phamngocty/quickshifter-esp32c3/docs/images/wiring-overview.jpg

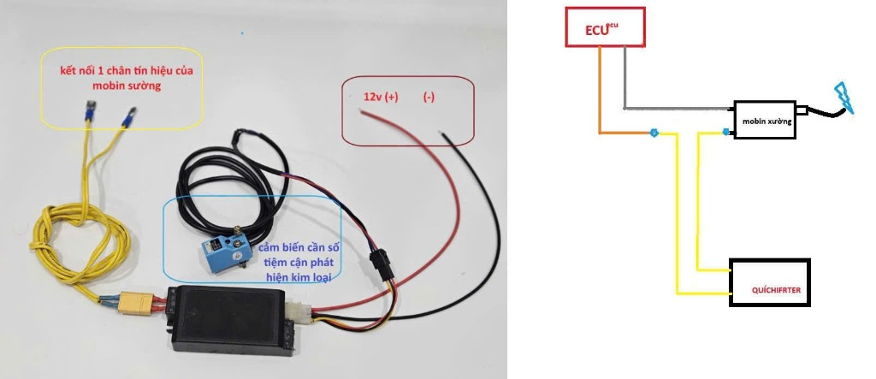
docs/images/wiring-overview.jpg
