phamngocty/quickshifter-esp32c3/docs/images/sensor-install.jpg

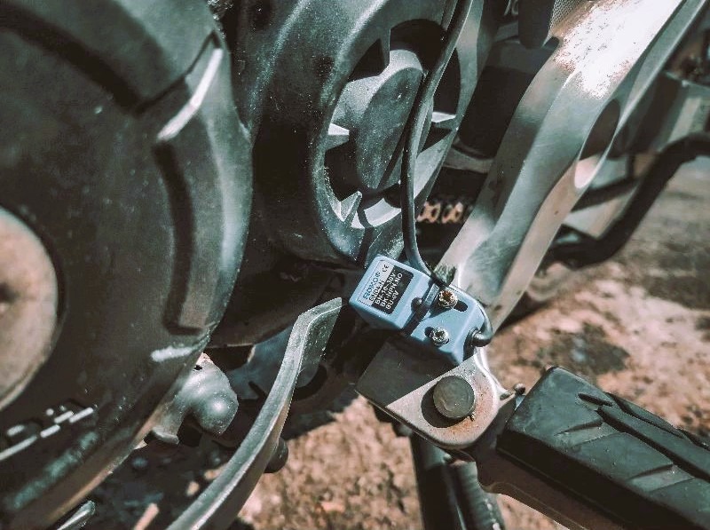
docs/images/sensor-install.jpg
