phamngocty/quickshifter-esp32c3/.gitnexus/context.md

### [00:22:28 26/3/2026]
**User:** luôn trả lời tiếng việt
