phamngocty/quickshifter-esp32c3/docs/nhiemvu.md

tôi muốn thêm chế độ Backfire manual  và tab backfrire
kịch bản thực tế hoạt động như sau :
xe đang mở khóa đang chạy bình thường Khi nhấn giữ Shift npn lớn hơn 3 giây (thời gian này có thể điều chỉnh )
