phamngocty/quickshifter-esp32c3/docs/images/control-box.jpg

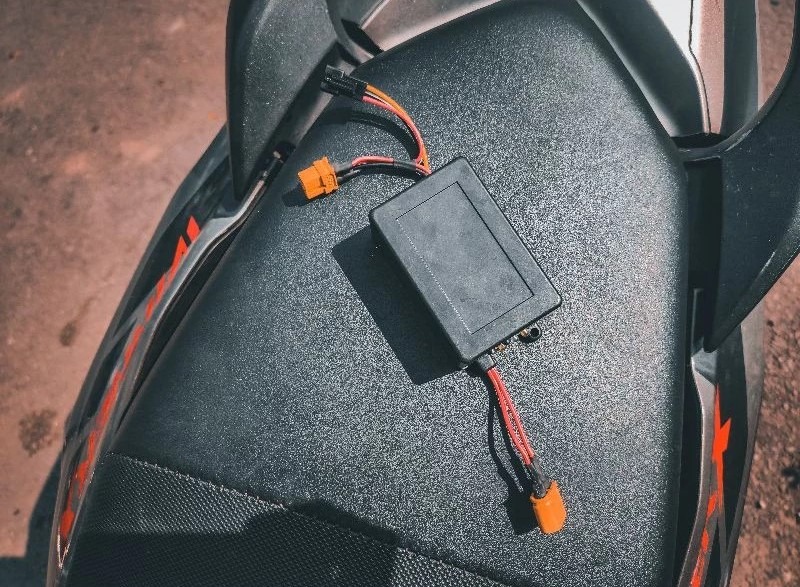
docs/images/control-box.jpg
