phamngocty/quickshifter-esp32c3/docs/images/mobin-real.png

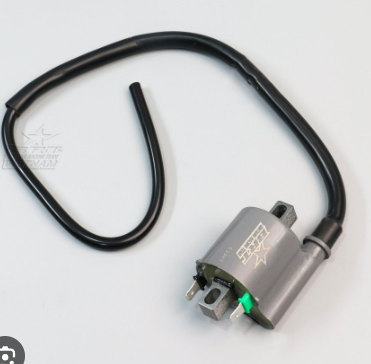
docs/images/mobin-real.png
