phamngocty/quickshifter-esp32c3/docs/images/oem-schematic.png

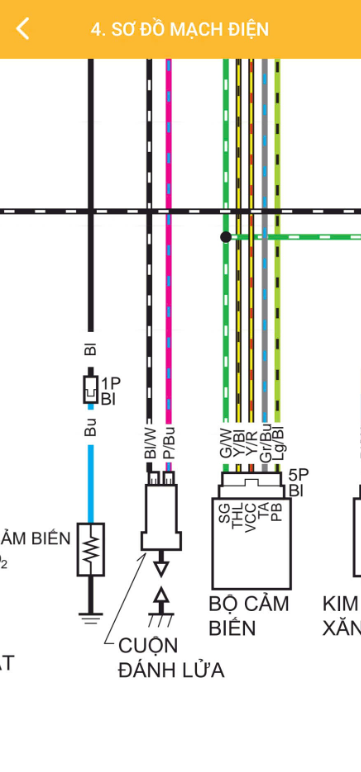
docs/images/oem-schematic.png
