phamngocty/quickshifter-esp32c3/docs/images/winner-full-schematic.png

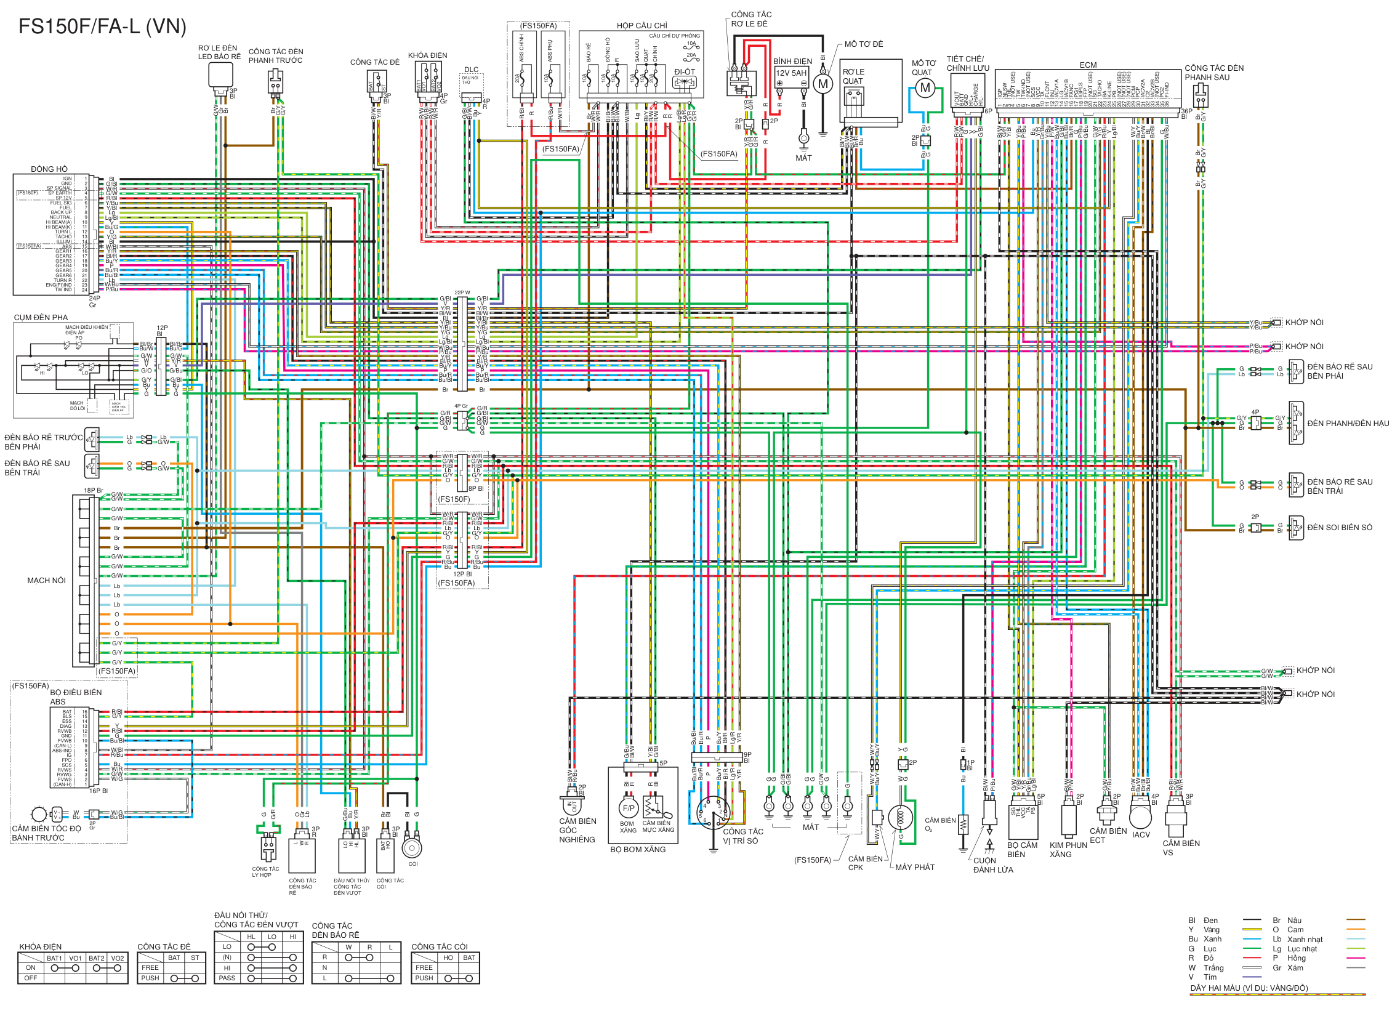
docs/images/winner-full-schematic.png
