phamngocty/quickshifter-esp32c3/release_package/docs/images/spade-connectors.jpg

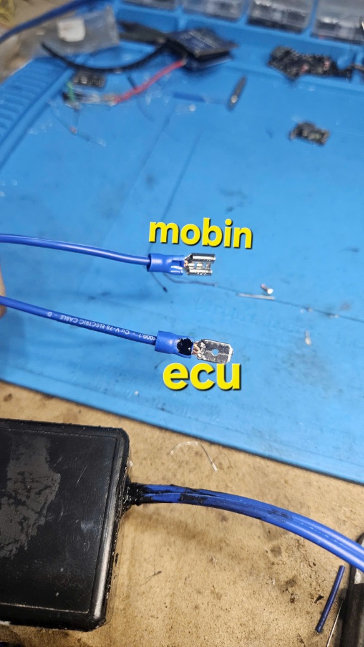
release_package/docs/images/spade-connectors.jpg
