phamngocty/quickshifter-esp32c3/scratch/pcb/P1_topleft.png

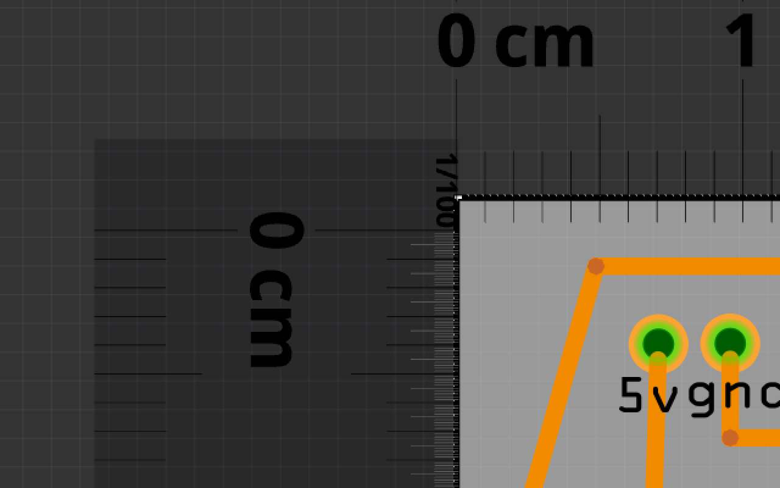
scratch/pcb/P1_topleft.png
