phamngocty/quickshifter-esp32c3/scratch/pcb/P2_topmid.png

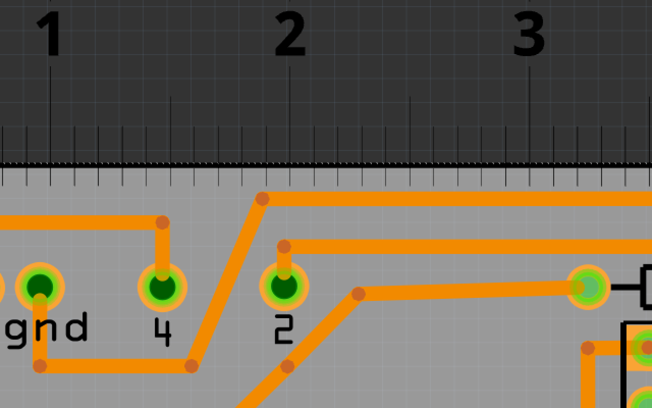
scratch/pcb/P2_topmid.png
