phamngocty/quickshifter-esp32c3/scratch/pcb/P3_right.png

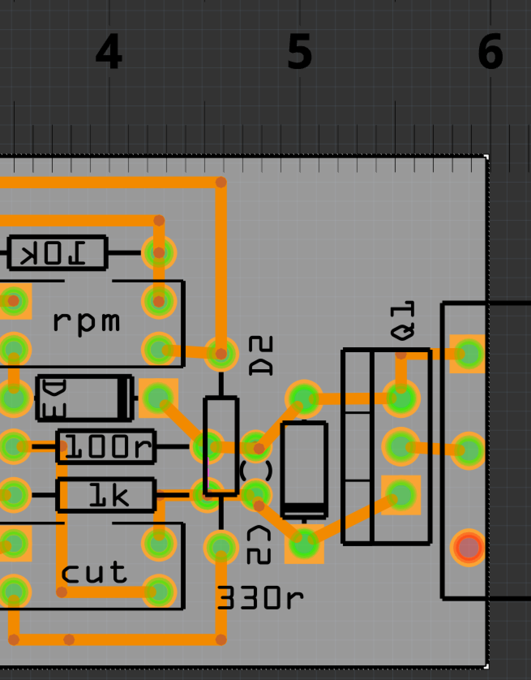
scratch/pcb/P3_right.png
