phamngocty/quickshifter-esp32c3/scratch/pcb/P4_botleft.png

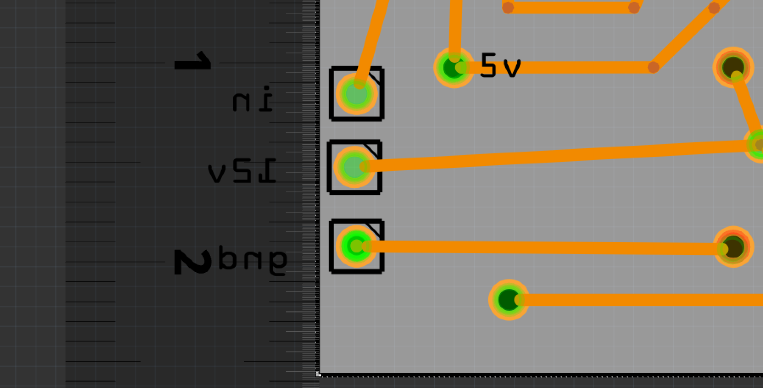
scratch/pcb/P4_botleft.png
