phamngocty/quickshifter-esp32c3/scratch/sch/A_left.png

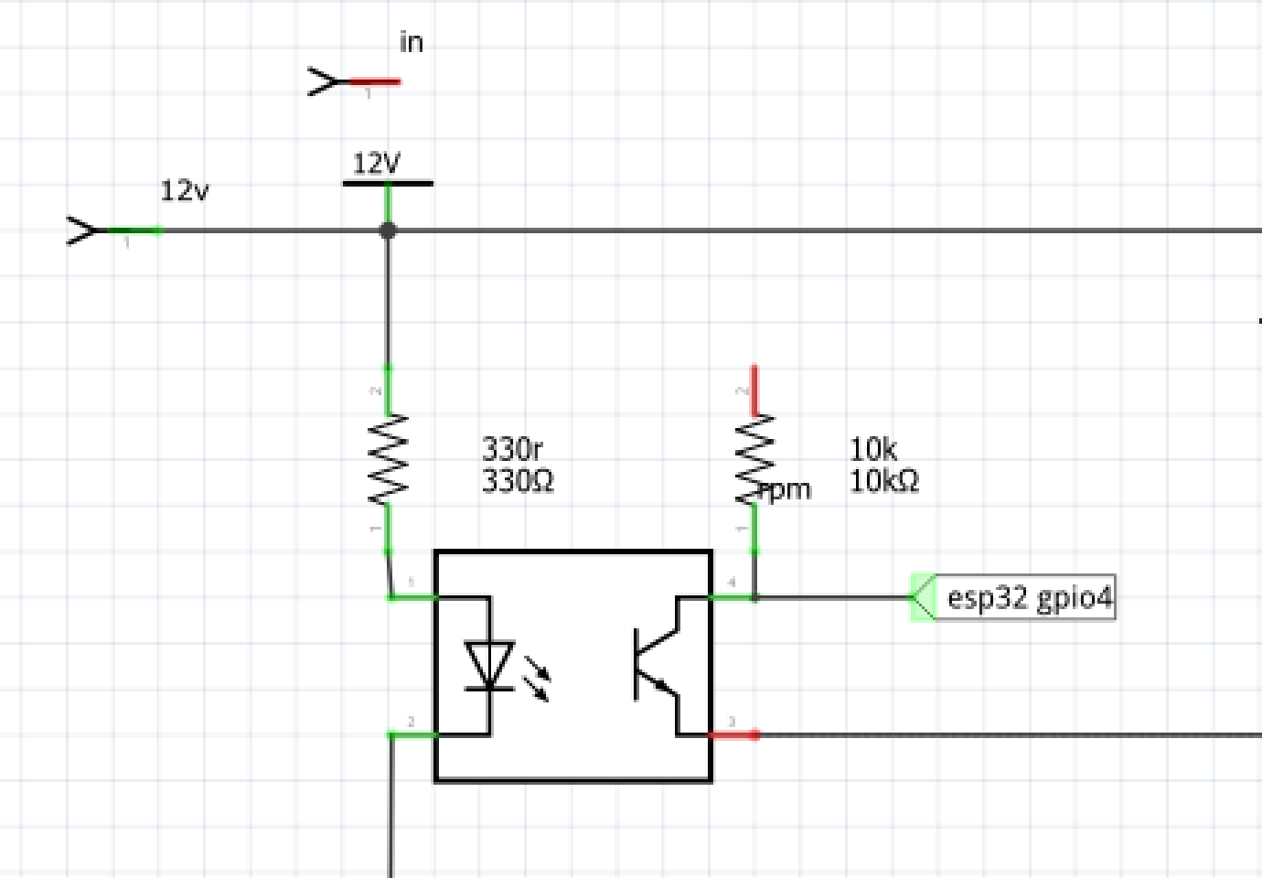
scratch/sch/A_left.png
