phamngocty/quickshifter-esp32c3/scratch/sch/B_mid.png

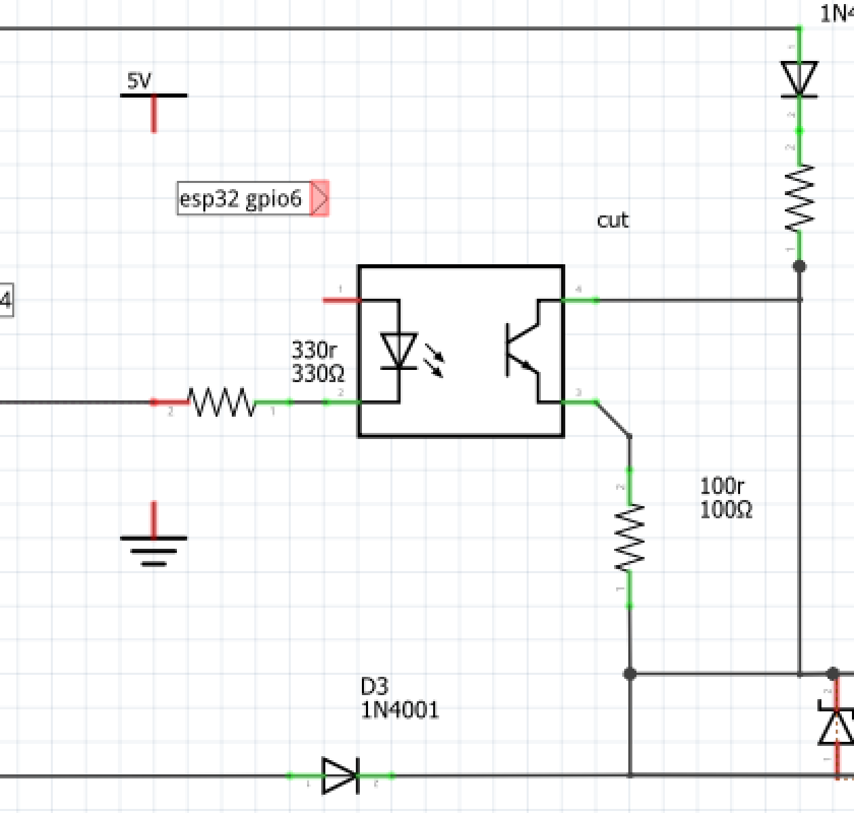
scratch/sch/B_mid.png
