phamngocty/quickshifter-esp32c3/scratch/sch/C_right.png

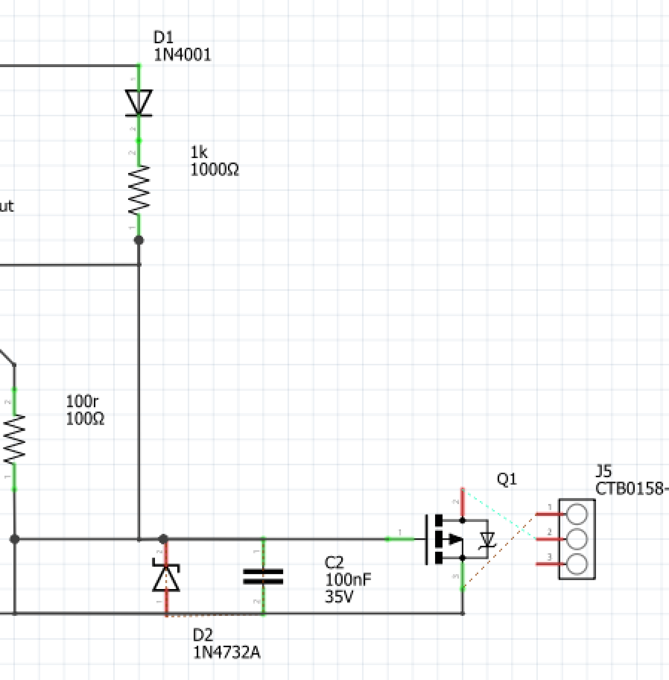
scratch/sch/C_right.png
