phamngocty/quickshifter-esp32c3/scratch/sch/D_bot.png

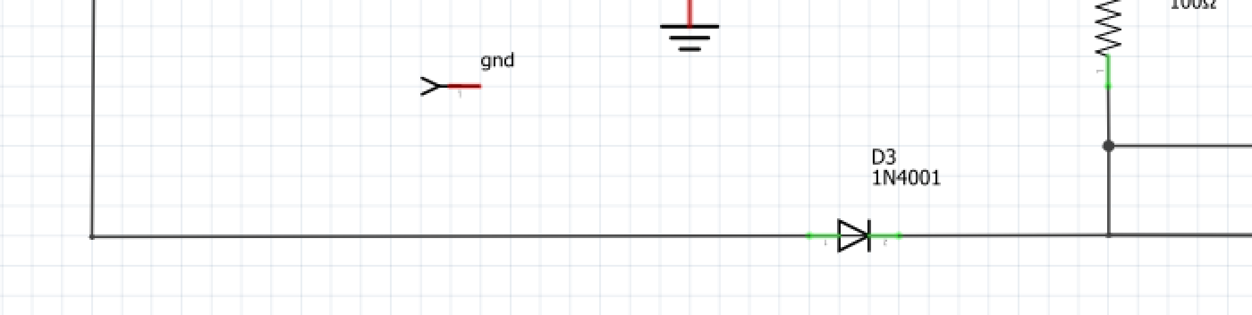
scratch/sch/D_bot.png
