phamngocty/quickshifter-esp32c3/scratch/sch/E_u1right_u2left.png

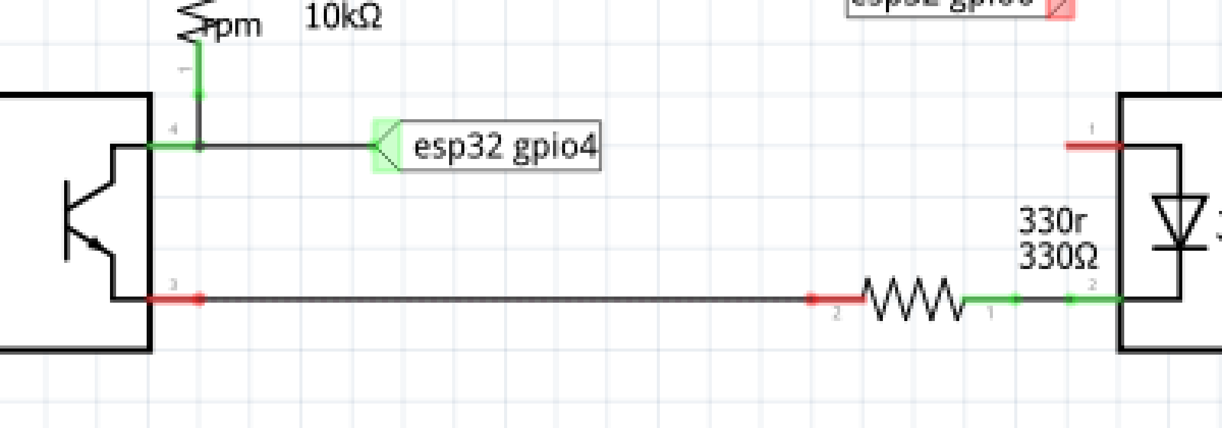
scratch/sch/E_u1right_u2left.png
