phamngocty/quickshifter-esp32c3/scratch/sch/F_u2right.png

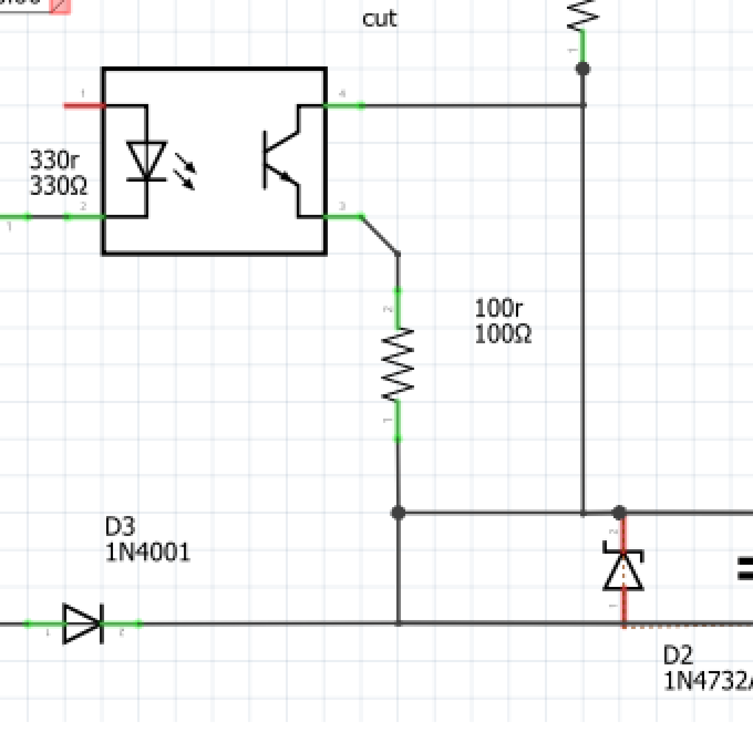
scratch/sch/F_u2right.png
