phamngocty/quickshifter-esp32c3/scratch/sch/G_q1_j5.png

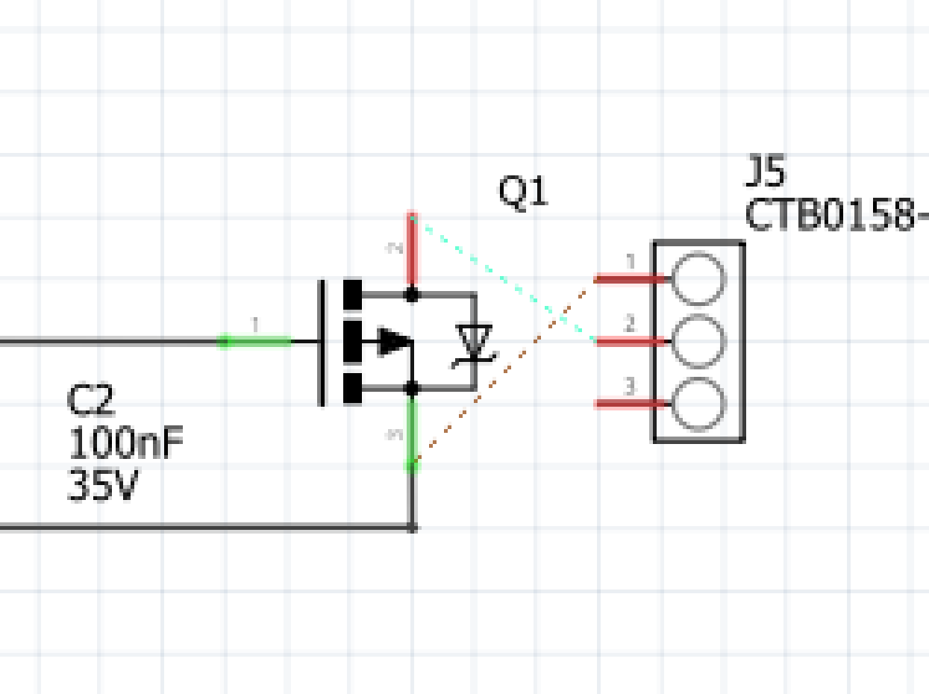
scratch/sch/G_q1_j5.png
