phamngocty/quickshifter-esp32c3/scratch/sch/H_u2pins.png

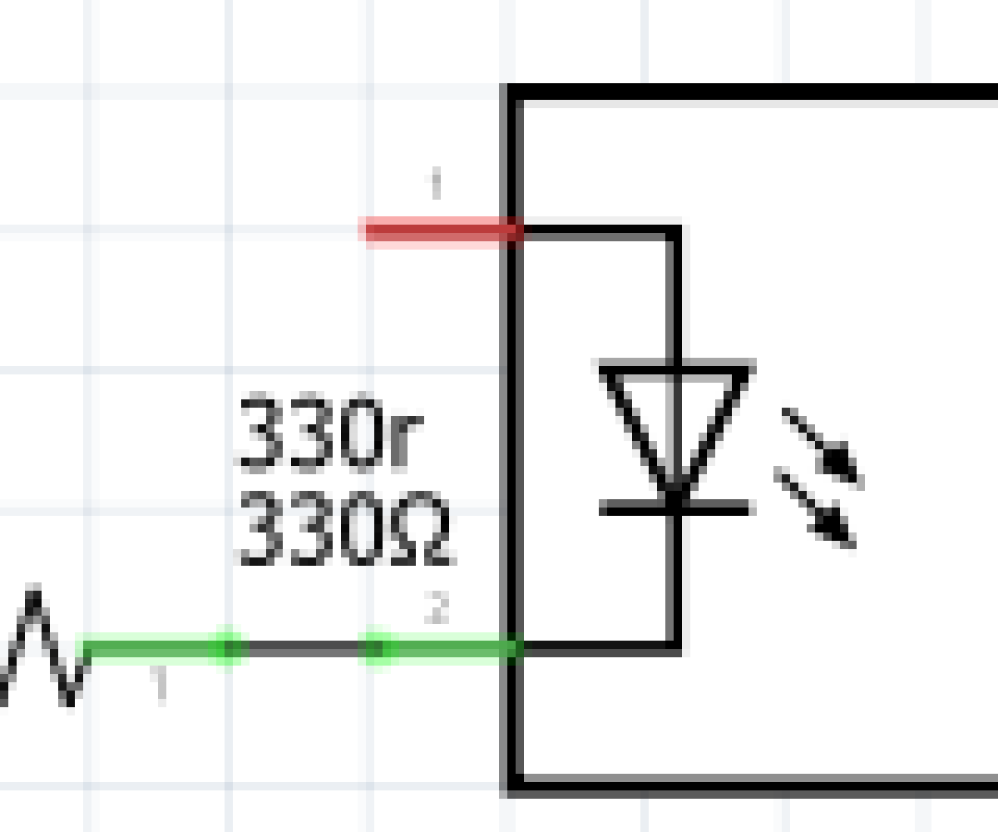
scratch/sch/H_u2pins.png
