phamngocty/quickshifter-esp32c3/hardware/quickshifter-c3-ign/quickshifter-c3-ign.kicad_pcb

## KiCad design hardware/quickshifter-c3-ign/quickshifter-c3-ign.kicad_pcb (2026-10-25)

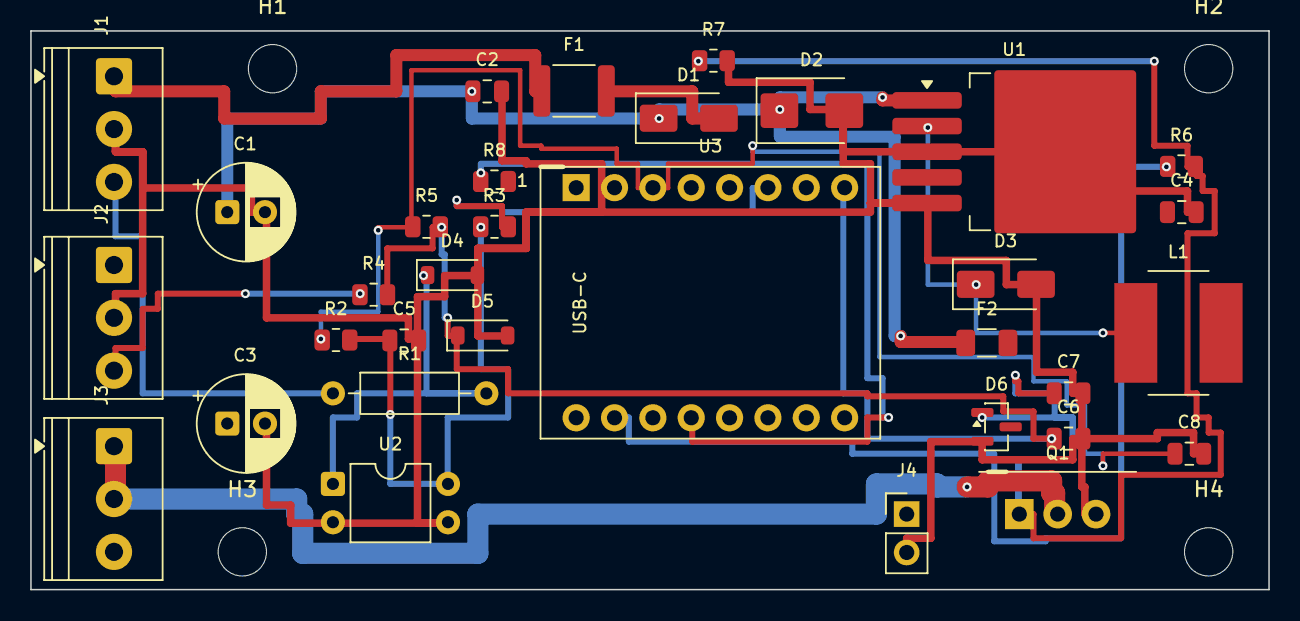
[picture p21: board quickshifter-c3-ign.kicad_pcb from above]

Board: 2 copper layers, 82.0 x 37.0 mm, 37 parts (0 on the bottom side), 19 nets.

Parts:
C1: 100uF/25V; CP_Radial_D6.3mm_P2.50mm
C2, C4, C7, C8: 100nF; C_0805_2012Metric
C3: 220uF/16V; CP_Radial_D6.3mm_P2.50mm
C5, C6: 10nF; C_0805_2012Metric
D1, D3: SS34; D_SMA
D2: SMBJ18A; D_SMB
D4: 1N4148; D_SOD-123
D5: BZT52C5V1; D_SOD-123
D6: BZX84C15; SOT-23
F1: 1.1A; Fuse_1812_4532Metric
F2: 0.5A; Fuse_1206_3216Metric
H1, H2, H3, H4: MountingHole_3.2mm_M3
J1: BIKE 12V/GND/RPM; TerminalBlock_Phoenix_PT-1,5-3-3.5-H_1x03_P3.50mm_Horizontal
J2: SN04-N; TerminalBlock_Phoenix_PT-1,5-3-3.5-H_1x03_P3.50mm_Horizontal
J3: IGN TRIGGER CUT; TerminalBlock_Phoenix_PT-1,5-3-3.5-H_1x03_P3.50mm_Horizontal
J4: TEST_PWM; PinHeader_1x02_P2.54mm_Vertical
L1: 100uH; L_Bourns_SRN8040TA
Q1: IRGB14C40L; TO-220_Standing
R1: 4k7 0.5W; R_Axial_DIN0207_L6.3mm_D2.5mm_P10.16mm_Horizontal
R2, R5, R7: 10k; R_0805_2012Metric
R3, R8: 1k; R_0805_2012Metric
R4: 4k7; R_0805_2012Metric
R6: 100; R_0805_2012Metric
U1: LM2596S-5.0; TO-263-5_TabPin3
U2: PC817; DIP-4_W7.62mm
U3: ESP32-C3-SuperMini

Connections:
+3V3: C8.1, R2.1, R5.1, U3.3
+5V: C3.1, C4.1, L1.2, U1.4, U3.1
+12V_F: D1.2, F1.2
+12V_IN: F1.1, J1.1
+12V_P: C1.1, C2.1, D1.1, D2.1, F2.1, U1.1
+12V_SENS: F2.2, J2.1
GND: C1.2, C2.2, C3.2, C4.2, C5.2, C6.2, C7.2, C8.2, D2.2, D3.2, D4.2, D5.2, D6.2, J1.2, J2.2, J4.2, Q1.3, R7.2, U1.3, U1.5, U2.2, U2.3, U3.2
IGBT_G: C7.1, D6.1, Q1.1, R6.2, R7.1
IGN_DRV: R6.1, U3.10
RPM_IN: J1.3, R1.1
RPM_LED_A: D4.1, R1.2, U2.1
RPM_OPT: C5.1, R2.2, R3.1, U2.4
RPM_SIG: R3.2, U3.6
SHIFT_IN: J2.3, R4.1
SHIFT_SIG: C6.1, D5.1, R4.2, R5.2, U3.8
SW_NODE: D3.1, L1.1, U1.2
TEST_PWM: R8.1, U3.12
TEST_PWM_OUT: J4.1, R8.2
TRIG: J3.1, J3.2, Q1.2
