phamngocty/quickshifter-esp32c3/scratch/kicad_smoke/t.kicad_sch

## KiCad design scratch/kicad_smoke/t.kicad_sch (2026-10-25)

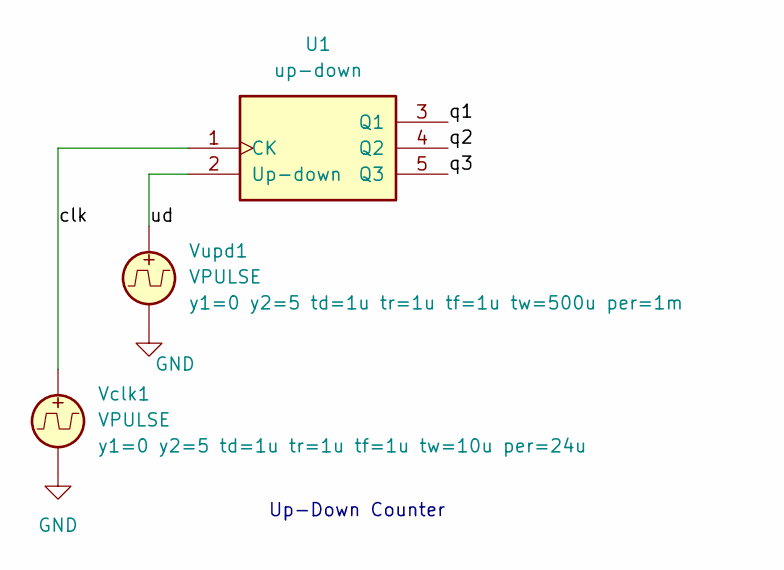
[picture p22: schematic t.kicad_sch]

Parts:
U1: up-down
Vclk1: VPULSE
Vupd1: VPULSE

Connections:
GND: Vclk1.2, Vupd1.2
clk: U1.1 (CK), Vclk1.1
q1: U1.3 (Q1)
q2: U1.4 (Q2)
q3: U1.5 (Q3)
ud: U1.2 (Up-down), Vupd1.1

Notes on the sheet:
Up-Down Counter
