phamngocty/quickshifter-esp32c3/src/rpm.cpp

#include "rpm.h"
#include <Arduino.h>

static volatile uint32_t pulseCount = 0;
static volatile uint32_t acceptedPulseCount = 0;
static volatile uint32_t lastEdgeUs = 0;
static volatile uint32_t lastValidPeriodUs = 0;
static volatile uint32_t minValidPeriodUs = 250;

static unsigned long lastUpdateMs = 0;
static int lastRpm = 0;
static int lastRawRpm = 0;
static float scale = 1.0f;
static float offsetRpm = 0.0f;
static float pprVal = 1.0f;

static const uint32_t MIN_PERIOD_FLOOR_US = 250;
static const uint32_t MAX_MEASURABLE_RPM = 24000;
static const uint32_t SIGNAL_TIMEOUT_US = 300000;
static const uint32_t UPDATE_INTERVAL_MS = 20;
static const uint8_t RPM_MA_SIZE = 6;

static float rpmBuffer[RPM_MA_SIZE] = {0.0f};
static uint8_t rpmBufferIndex = 0;
static uint8_t rpmBufferCount = 0;
static uint32_t lastAcceptedSnapshot = 0;

static inline void rpm_recompute_min_period()
{
  float pprLocal = pprVal;
  if (pprLocal < 0.01f)
    pprLocal = 0.01f;
  float periodUs = 60000000.0f / (MAX_MEASURABLE_RPM * pprLocal);
  uint32_t computed = static_cast<uint32_t>(periodUs);
  if (computed < MIN_PERIOD_FLOOR_US)
    computed = MIN_PERIOD_FLOOR_US;
  minValidPeriodUs = computed;
}

static inline void rpm_filter_reset()
{
  for (uint8_t i = 0; i < RPM_MA_SIZE; ++i)
  {
    rpmBuffer[i] = 0.0f;
  }
  rpmBufferIndex = 0;
  rpmBufferCount = 0;
}

static inline void rpm_filter_push(float rpm)
{
  rpmBuffer[rpmBufferIndex] = rpm;
  rpmBufferIndex = (rpmBufferIndex + 1) % RPM_MA_SIZE;
  if (rpmBufferCount < RPM_MA_SIZE)
  {
    rpmBufferCount++;
  }
}

static inline float rpm_filter_average()
{
  if (rpmBufferCount == 0)
  {
    return 0.0f;
  }
  float sum = 0.0f;
  for (uint8_t i = 0; i < rpmBufferCount; ++i)
  {
    sum += rpmBuffer[i];
  }
  return sum / rpmBufferCount;
}

static void IRAM_ATTR rpm_isr()
{
  const uint32_t nowUs = static_cast<uint32_t>(micros());
  const uint32_t prevUs = lastEdgeUs;

  if (prevUs != 0)
  {
    const uint32_t deltaUs = nowUs - prevUs;
    if (deltaUs < minValidPeriodUs)
    {
      return;
    }
    lastValidPeriodUs = deltaUs;
  }

  lastEdgeUs = nowUs;
  pulseCount++;
  acceptedPulseCount++;
}

void rpm_set_ppr(float ppr)
{
  if (ppr <= 0.01f)
  {
    ppr = 0.01f;
  }
  pprVal = ppr;
  rpm_recompute_min_period();
}

void rpm_set_scale(float factor)
{
  if (factor <= 0.01f)
    factor = 0.01f;
  scale = factor;
}

void rpm_set_offset(float offset)
{
  offsetRpm = offset;
}

float rpm_get_scale()
{
  return scale;
}

float rpm_get_offset()
{
  return offsetRpm;
}

void rpm_init(uint8_t pin)
{
  noInterrupts();
  pulseCount = 0;
  acceptedPulseCount = 0;
  lastEdgeUs = 0;
  lastValidPeriodUs = 0;
  interrupts();

  lastUpdateMs = millis();
  lastAcceptedSnapshot = 0;
  lastRpm = 0;
  lastRawRpm = 0;
  rpm_filter_reset();
  rpm_recompute_min_period();

  pinMode(pin, INPUT_PULLUP);
  attachInterrupt(digitalPinToInterrupt(pin), rpm_isr, RISING);
}

void rpm_update()
{
  const unsigned long nowMs = millis();
  const unsigned long elapsedMs = nowMs - lastUpdateMs;
  if (elapsedMs < UPDATE_INTERVAL_MS)
  {
    return;
  }
  lastUpdateMs = nowMs;

  uint32_t periodUsSnapshot = 0;
  uint32_t acceptedSnapshot = 0;
  uint32_t lastEdgeSnapshot = 0;

  noInterrupts();
  periodUsSnapshot = lastValidPeriodUs;
  acceptedSnapshot = acceptedPulseCount;
  lastEdgeSnapshot = lastEdgeUs;
  interrupts();

  uint32_t pulseDelta = acceptedSnapshot - lastAcceptedSnapshot;
  if (pulseDelta > 0)
  {
    float rawRpm = 0.0f;
    if (periodUsSnapshot >= minValidPeriodUs)
    {
      rawRpm = 60000000.0f / (periodUsSnapshot * pprVal);
    }
    lastRawRpm = static_cast<int>(rawRpm + 0.5f);
    rawRpm = (rawRpm * scale) + offsetRpm;
    if (rawRpm < 0.0f)
    {
      rawRpm = 0.0f;
    }
    rpm_filter_push(rawRpm);
    lastAcceptedSnapshot = acceptedSnapshot;
  }

  const uint32_t nowUs = static_cast<uint32_t>(micros());
  if (lastEdgeSnapshot == 0 || (nowUs - lastEdgeSnapshot) > SIGNAL_TIMEOUT_US)
  {
    rpm_filter_reset();
    lastRpm = 0;
    lastRawRpm = 0;
    return;
  }

  lastRpm = static_cast<int>(rpm_filter_average() + 0.5f);
}

static int simulatedRpm = 0;

void rpm_set_simulated(int rpm)
{
  simulatedRpm = (rpm < 0) ? 0 : rpm;
}

int rpm_get_simulated()
{
  return simulatedRpm;
}

int rpm_get()
{
  if (lastRpm > 0)
    return lastRpm;
  return simulatedRpm;
}

int rpm_get_raw()
{
  if (lastRawRpm > 0)
    return lastRawRpm;
  return simulatedRpm;
}
