phamngocty/quickshifter-esp32c3/src/rpm.h

#pragma once
#include <Arduino.h>

void rpm_init(uint8_t pin);
void rpm_update(); // call from loop to compute rpm periodically
int rpm_get();
int rpm_get_raw();
void rpm_set_ppr(float ppr);
void rpm_set_scale(float factor);
void rpm_set_offset(float offsetRpm);
float rpm_get_scale();
float rpm_get_offset();
void rpm_set_simulated(int rpm);
int rpm_get_simulated();
