phamngocty/quickshifter-esp32c3/(commit log)

2026-01-08 tạo init
2026-01-13 sữa lưu cấu hình back frie manual
2026-01-14 sữa backfrire mode 2 chưa xong
2026-03-14 sữa rpm đọc xung ecu
2026-03-17 fixCác cải tiến đã thực hiện 1. Bảo vệ Quickshift ở tua thấp (Min RPM Guard) Vấn đề: Trước đây quickshift có thể kích hoạt ở bất kỳ RPM nào, dễ gây chết máy khi đi chậm. Giải pháp: Thêm Guard conditi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
2026-09-20 fix: lỗi tìm ẩn
2026-09-24 fixỗi cut
2026-09-25 fix: lỗi giư cần số
2026-11-09 feat: trức khi sữa lỗi
2026-11-09 update: trả lủa mmeemf
