phamngocty/quickshifter-esp32c3/(notices)

Notices in the files:
README.md:
License: MIT
